simoesusp/high-speed-robot/Experimental results/navegacao/teste.txt

27	78	62	970	967
27	78	62	970	967
27	78	62	970	967
27	78	62	970	967
28	78	62	970	967
27	78	62	970	967
27	78	62	970	967
27	78	62	970	967
27	78	62	970	967
27	78	62	970	967
27	78	62	970	967
27	78	62	970	967
27	78	62	970	967
27	78	62	970	967
27	78	62	970	967
27	78	62	970	967
27	78	62	970	967
27	78	62	970	967
27	78	62	970	967
27	78	62	970	967
27	78	62	970	967
27	78	62	970	967
27	78	62	970	967
27	78	62	970	967
28	78	62	970	967
27	78	62	970	967
27	78	62	970	967
27	78	62	970	967
29	78	62	970	967
27	78	62	970	967
27	78	62	970	967
27	78	62	970	967
27	78	62	970	967
27	78	62	970	967
27	78	62	970	967
27	78	62	970	967
27	78	62	970	967
27	78	62	970	967
27	78	62	970	967
27	78	62	970	967
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
