simoesusp/high-speed-robot/Experimental results/navegacao/log2.xlsx

esquerda | meio | direita | motor1 | motor2
80 | 80 | 29 | 965 | 970 | 5 | 0 | 79.5 | 28
80 | 80 | 28 | 965 | 970 | 5 | 0 | 79.5 | 27
80 | 80 | 28 | 965 | 970 | 5 | 0 | 79.5 | 27
80 | 80 | 26 | 965 | 970 | 5 | 0 | 79.5 | 25
80 | 80 | 26 | 965 | 970 | 5 | 0 | 79.5 | 25
80 | 80 | 28 | 965 | 970 | 5 | 0 | 79.5 | 27
80 | 80 | 80 | 965 | 965 | 5 | 5 | 79.5 | 79
80 | 80 | 80 | 965 | 965 | 5 | 5 | 79.5 | 79
80 | 80 | 80 | 965 | 965 | 5 | 5 | 79.5 | 79
80 | 80 | 80 | 965 | 965 | 5 | 5 | 79.5 | 79
80 | 80 | 80 | 965 | 965 | 5 | 5 | 79.5 | 79
53 | 80 | 80 | 968 | 965 | 2 | 5 | 79.5 | 79
47 | 80 | 80 | 969 | 965 | 1 | 5 | 79.5 | 79
43 | 80 | 80 | 969 | 965 | 1 | 5 | 79.5 | 79
39 | 80 | 80 | 970 | 965 | 0 | 5 | 79.5 | 79
37 | 80 | 80 | 970 | 965 | 0 | 5 | 79.5 | 79
39 | 80 | 80 | 970 | 965 | 0 | 5 | 79.5 | 79
80 | 80 | 80 | 965 | 965 | 5 | 5 | 79.5 | 79
80 | 80 | 80 | 965 | 965 | 5 | 5 | 79.5 | 79
80 | 80 | 80 | 965 | 965 | 5 | 5 | 79.5 | 79
80 | 80 | 80 | 965 | 965 | 5 | 5 | 79.5 | 79
80 | 80 | 61 | 965 | 967 | 5 | 3 | 79.5 | 60
80 | 80 | 54 | 965 | 968 | 5 | 2 | 79.5 | 53
80 | 80 | 47 | 965 | 969 | 5 | 1 | 79.5 | 46
80 | 80 | 39 | 965 | 970 | 5 | 0 | 79.5 | 38
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
