simoesusp/high-speed-robot/Experimental results/teste_angulo/Pasta1.xlsx

0g | 10g | 20g | 30g | 40g | 45g | 60g
96 | 96 | 96 | 97 | 98 | 100 | 164
96 | 96 | 96 | 97 | 99 | 99 | 164
96 | 96 | 96 | 97 | 99 | 99 | 164
96 | 96 | 96 | 97 | 99 | 99 | 164 | Ângulo | 0° | 10° | 20° | 30° | 40° | 45° | 60°
96 | 96 | 96 | 97 | 99 | 100 | 164 | Média | 100 | 100 | 100.25 | 101 | 102.8333333 | 103.5833333 | 167.6666667
96 | 96 | 96 | 97 | 99 | 99 | 163 | Desvio padrão | 0 | 0 | 0.375 | 0 | 0.2777777778 | 0.5833333333 | 0.4444444444
96 | 96 | 96 | 97 | 99 | 99 | 163
96 | 96 | 97 | 97 | 99 | 99 | 164
96 | 96 | 97 | 97 | 98 | 100 | 164
96 | 96 | 97 | 97 | 99 | 100 | 163
96 | 96 | 96 | 97 | 99 | 101 | 163
96 | 96 | 96 | 97 | 99 | 100 | 164
