simoesusp/high-speed-robot/Experimental results/teste_angulo/resultados.xlsx

0g70cm | 0g 150cm | 10g70cm | 10g150cm | 20g70cm | 20g150cm
70 | 135 | 70 | 134 | 72 | 2163
70 | 135 | 70 | 135 | 72 | 2163 | Distancia | Angulo |  | média
70 | 135 | 70 | 134 | 72 | 2163 | 70 | 0 |  | desvio padrão
70 | 135 | 70 | 135 | 72 | 2163 | 135 | 10
70 | 135 | 70 | 135 | 72 | 2163 |  | 20
70 | 135 | 70 | 135 | 72 | 2163
70 | 135 | 70 | 134 | 72 | 2163
70 | 135 | 70 | 134 | 72 | 2163
70 | 135 | 70 | 134 | 72 | 2163 | Distância | 70cm |  |  | 135cm
70 | 135 | 70 | 134 | 72 | 2163 | Ângulo | 0° | 10° | 20° | 0° | 10° | 20°
70 | 135 | 70 | 135 | 72 | 2163 | Média | 70.00 | 70.32 | 73.46 | 135.01 | 134.46 | 2162.97
70 | 135 | 70 | 134 | 72 | 2162 | Desvio padrão | 0.02 | 0.46 | 1.73 | 0.03 | 0.66 | 0.10
70 | 135 | 70 | 134 | 72 | 2163
70 | 135 | 70 | 134 | 72 | 2163
70 | 135 | 70 | 134 | 72 | 2163
70 | 135 | 70 | 134 | 72 | 2163
70 | 135 | 70 | 134 | 72 | 2163
70 | 135 | 70 | 134 | 71 | 2163
70 | 135 | 71 | 134 | 72 | 2163
70 | 135 | 70 | 134 | 72 | 2163
70 | 135 | 70 | 135 | 72 | 2163
70 | 135 | 70 | 134 | 72 | 2163
70 | 135 | 70 | 135 | 72 | 2163
70 | 135 | 70 | 134 | 72 | 2163
70 | 135 | 70 | 136 | 72 | 2163
70 | 135 | 70 | 135 | 72 | 2163
70 | 135 | 70 | 134 | 72 | 2163
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
