simoesusp/high-speed-robot/Experimental results/teste_carro/res.xlsx

20 km/h | 40 km/h | 60 km/h | 80 km/h | 100 km/h
96 | 94 | 96 | 98 | 96
97 | 96 | 96 | 98 | 100
96 | 95 | 97 | 97 | 100
97 | 93 | 97 | 98 | 97
98 | 90 | 97 | 99 | 99
97 | 92 | 97 | 99 | 97 | Velocidade | 20 km/h | 40 km/h | 60 km/h | 80 km/h | 100 km/h
100 | 94 | 97 | 99 | 97 | Altura média: | 97.25 | 96.975 | 96.525 | 96.275 | 98.975
99 | 95 | 96 | 98 | 100 | Desvio padrão | 0.7625 | 2.27625 | 1.29375 | 4.31375 | 1.47875
99 | 97 | 96 | 97 | 99
97 | 95 | 96 | 99 | 98
97 | 96 | 98 | 98 | 99
96 | 94 | 98 | 98 | 97
99 | 95 | 97 | 97 | 98
96 | 96 | 94 | 97 | 101
97 | 98 | 94 | 99 | 100
97 | 100 | 96 | 98 | 100
96 | 100 | 96 | 103 | 97
96 | 97 | 97 | 98 | 99
97 | 98 | 95 | 98 | 97
100 | 99 | 93 | 97 | 99
98 | 100 | 95 | 97 | 100
97 | 101 | 93 | 97 | 99
97 | 100 | 95 | 10 | 98
97 | 99 | 97 | 101 | 102
97 | 99 | 100 | 97 | 101
97 | 101 | 99 | 97 | 98
97 | 99 | 91 | 103 | 104
97 | 102 | 97 | 101 | 98
97 | 101 | 97 | 97 | 98
98 | 100 | 98 | 97 | 101
98 | 96 | 98 | 98 | 98
97 | 99 | 98 | 98 | 100
97 | 98 | 97 | 98 | 99
96 | 96 | 97 | 98 | 99
98 | 95 | 97 | 100 | 96
97 | 97 | 98 | 98 | 99
98 | 94 | 98 | 101 | 96
97 | 95 | 98 | 99 | 106
97 | 96 | 97 | 100 | 97
96 | 97 | 98 | 99 | 100
