simoesusp/high-speed-robot/SoftwareArduino/monografia/Imagens/robot_schem2.pdf

## sonar 0

## sonar 4

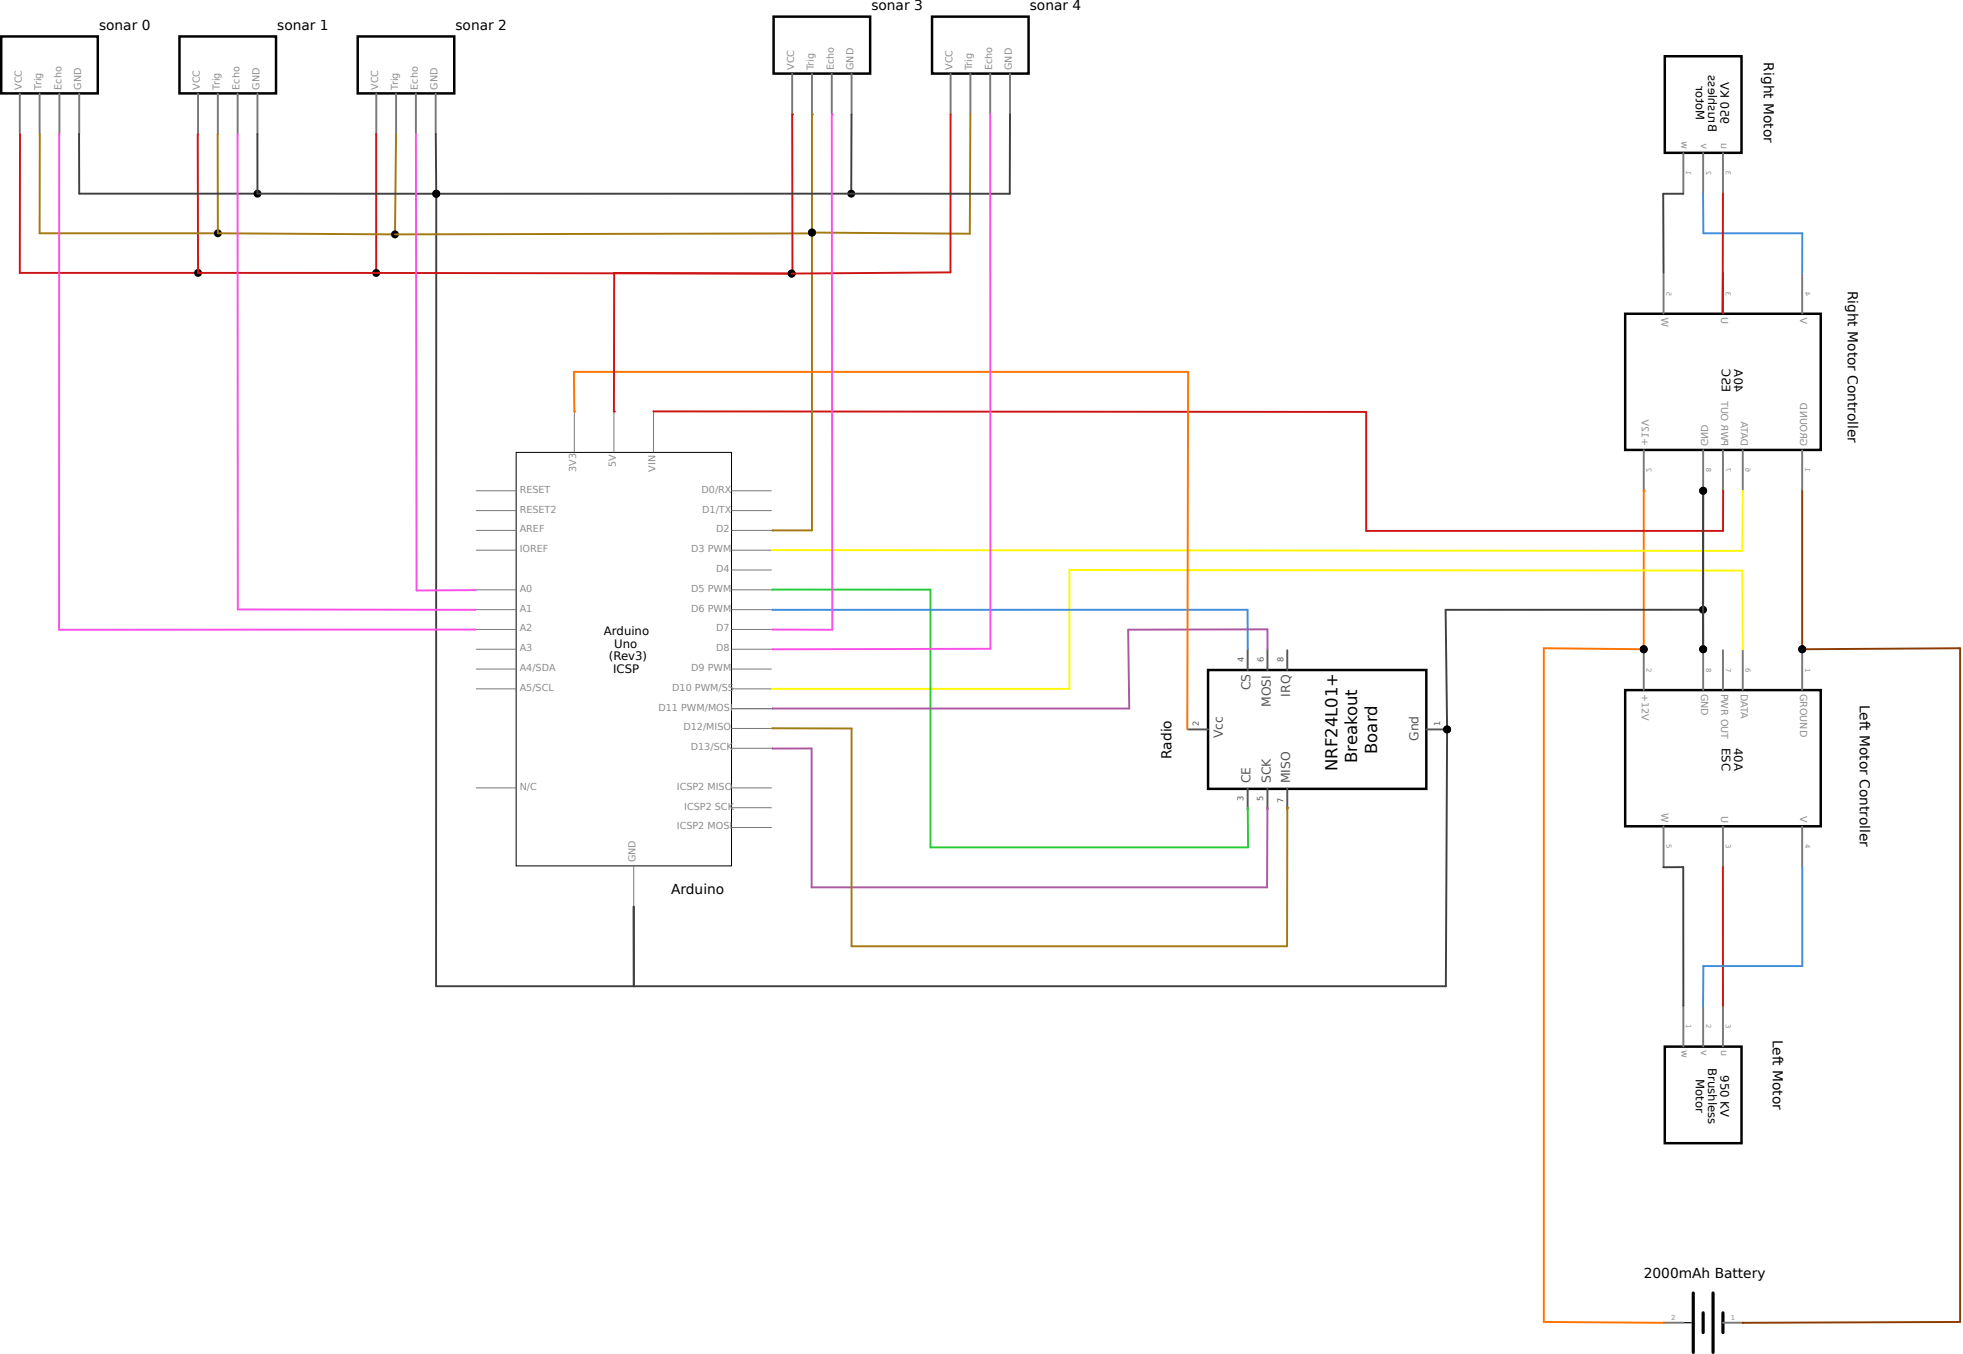
[picture p9: page 1]

Right Motor Left Motor
