simoesusp/high-speed-robot/SoftwareArduino/monografia/Imagens/robot_schem.pdf

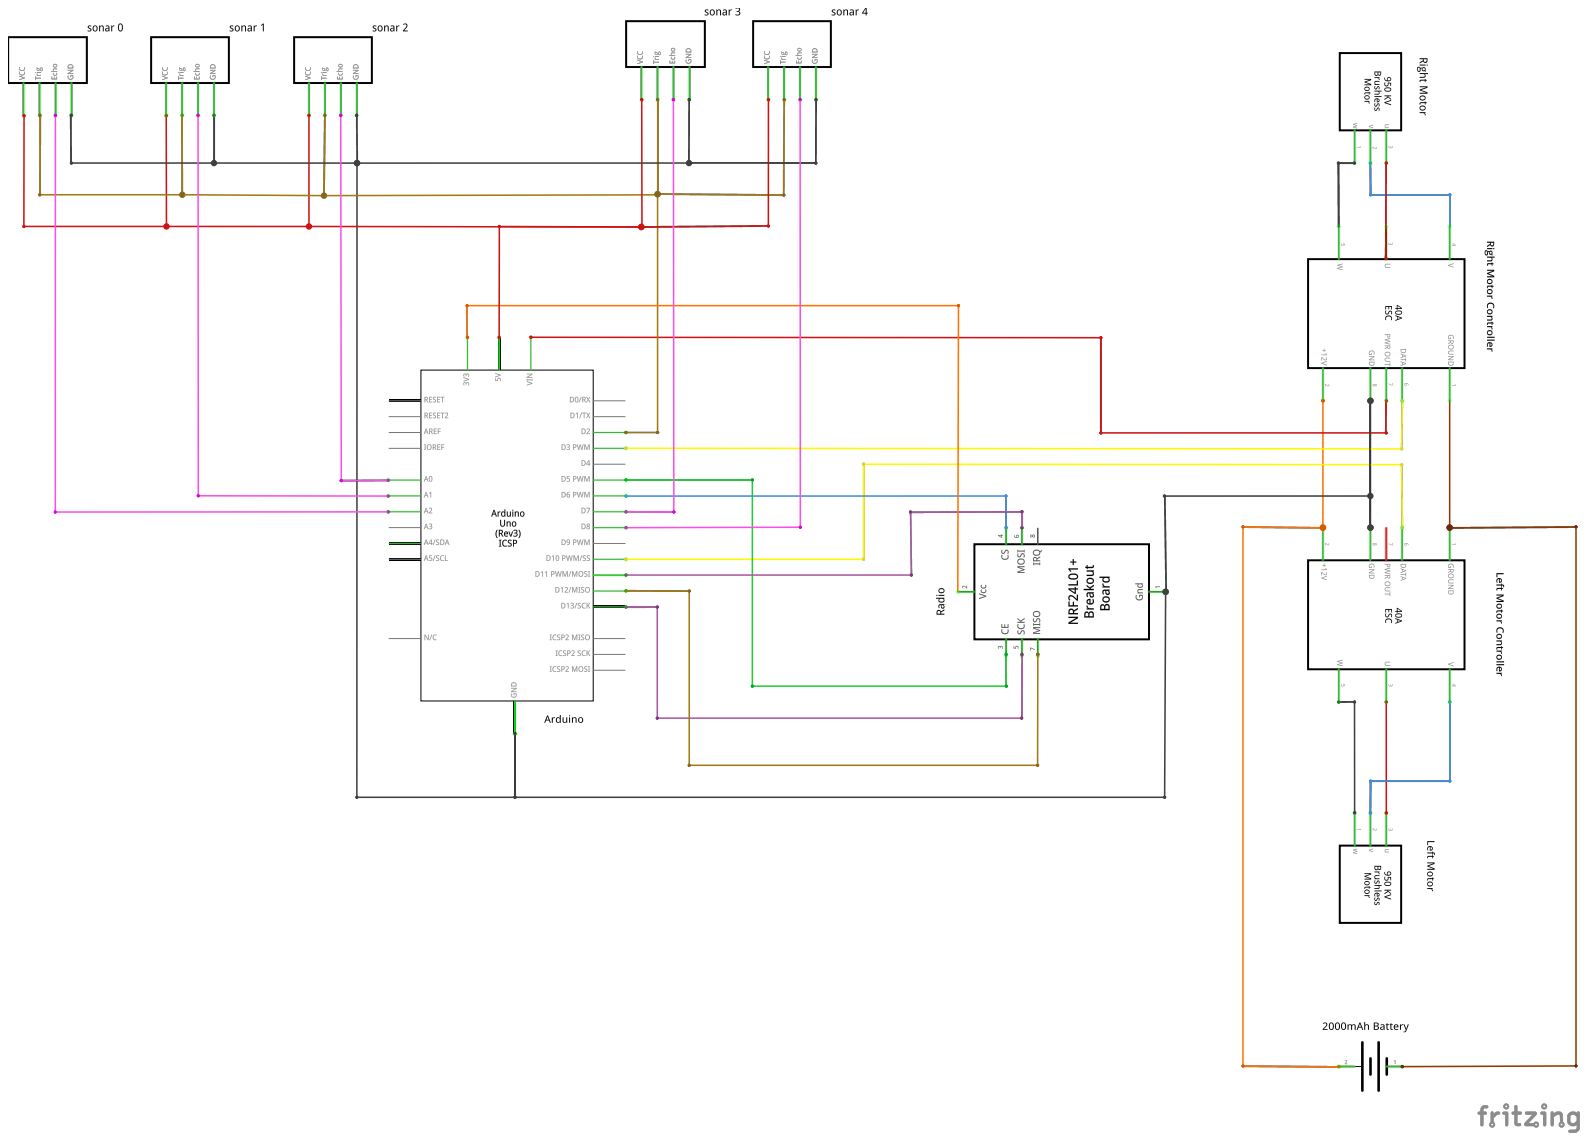
[picture p10: page 1]
