simoesusp/high-speed-robot/(commit log)

2015-06-11 Original version of code and results
    [Pasta1.xlsx, log.xlsx, log2.xlsx, res.xlsx, resultados.xlsx]
2015-06-11 Added Getting Started file
    Teach how to communicate with RaspberryPI Debian via WiFi
2015-09-03 Added Arduino version of the Robot controller
2015-09-20 Low Level Obstacle Avoidance Algorithm
    A very simple low level obstacle avoidance algorithm for a high speed
    robot using 5 ultrasonic sensors.
    [ObstAvoid.ino]
2016-08-03 remote control with obstacle avoidance algorithm
    [ObstAvoid.ino]
2016-08-23 added robot status feedback to remote control, changed micros() to millis() for a cleaner code, fixed stop() bug
    [ObstAvoid.ino]
2016-08-24 take distance into account in start() to avoid more accidents...
    [ObstAvoid.ino]
2016-09-20 switched it back to one trigger but set measuring interval constant
2016-10-25 removed measuring(); everything is done within myPulseIn(), that presents now dynamical and constant reading options; fixed pointer issue
    [ObstAvoid.ino]
2016-11-23 log function is now subdued to safety button
2016-12-10 adicionei um link do pdf para a pasta monografia.
2016-12-21 Added modified version of ObstAvoid code, added README.txt, fixed some bugs in ObstAvoid.ino as well (when all_sensors == 0 only 3 sensors are actually taken into account; added FullSpeed define; cha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
    [ObstAvoid_modificado.ino]
2017-04-23 working, though I gotta test prop contr better
